yogaperdana/room-telemetry/device/board/print.pdf

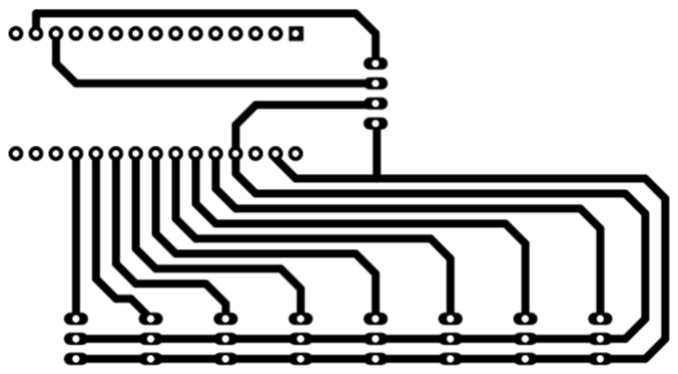
[picture p8: figure]
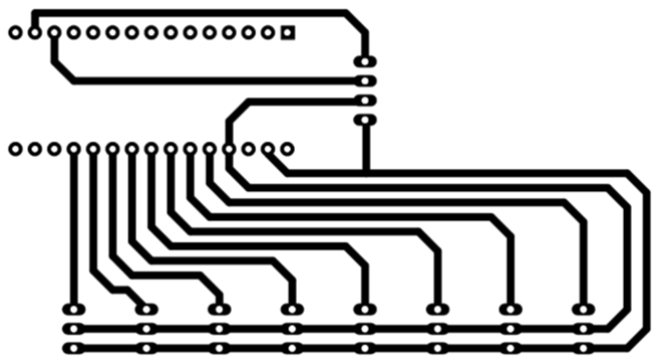
[picture p9: figure]
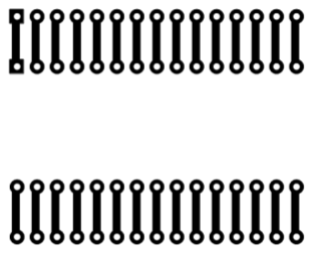
[picture p10: figure]
